camlang1444-ai/ong-gio-hvac/DXF/co90_400x200_L100_trai_phang.dxf

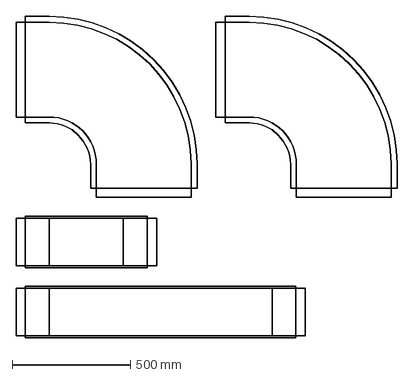
[picture p8: CAD file, 2026-11-07]
DXF/co90_400x200_L100_trai_phang.dxf
1610.0 x 1357.0 mm
