camlang1444-ai/ong-gio-hvac/STEP/co90_400x200_L100.step

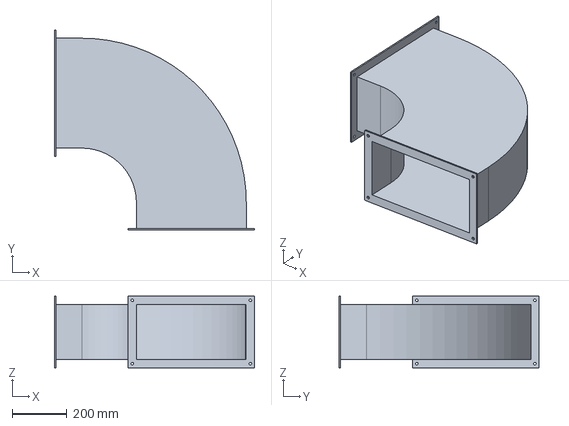
[picture p9: CAD file, 2026-11-07]
STEP/co90_400x200_L100.step
730.8 x 730.8 x 261.5 mm
