camlang1444-ai/ong-gio-hvac/STEP/ong_gio_700x200_L800.step

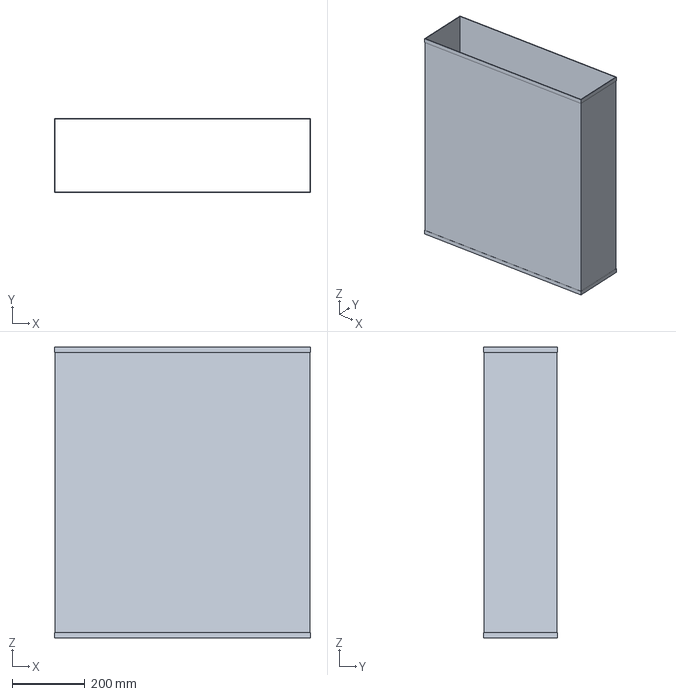
[picture p10: CAD file, 2026-11-07]
STEP/ong_gio_700x200_L800.step
704.5 x 204.5 x 800.0 mm
