camlang1444-ai/ong-gio-hvac/(list of files, cad)

Other CAD files:
STL/co90_400x200_L100.stl
STL/ong_gio_700x200_L800.stl
